tobycm/divine-light/cad/divine-light-low-detail.step

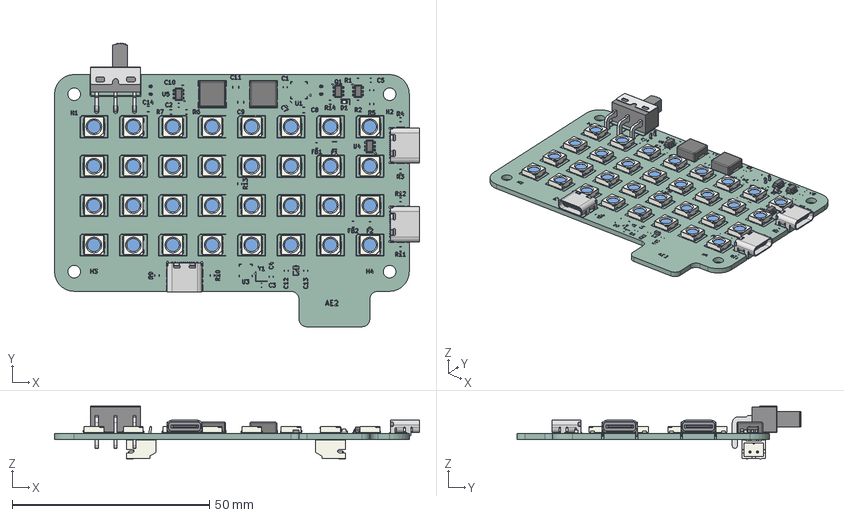
[picture p5: CAD file, 2026-11-07]
cad/divine-light-low-detail.step
92.6 x 72.0 x 13.4 mm
L_APV_APH0630 x 2
LED_SK6812_PLCC4_50x50mm_P32mm x 32
LED_0603_1608Metric
SOT-23-6 x 4
SW-TH_3P-P4.80_HX-SS12D10G6-WJ
USB-C-SMD_TYPE-C-6PIN-2MD-073 x 3
L_0603_1608Metric
JST_S2B_PH_K x 2
divine-light_silkscreen x 2
divine-light_PCB
