tobycm/divine-light/cad/divine-light.step

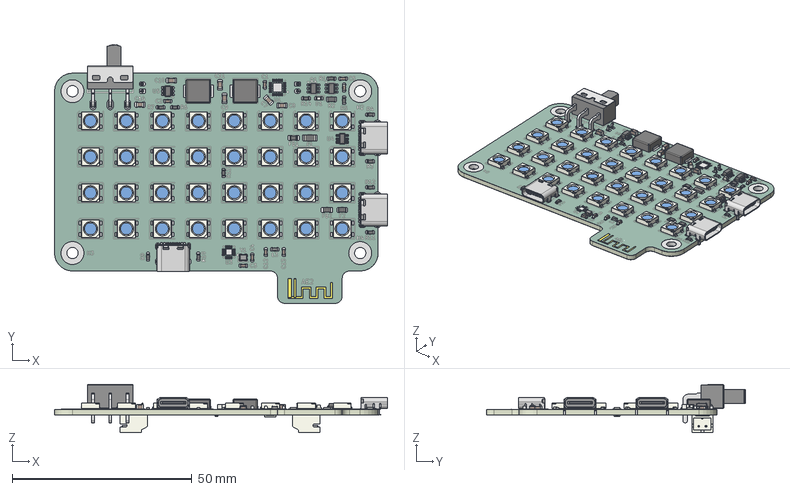
[picture p6: CAD file, 2026-11-06]
cad/divine-light.step
92.6 x 72.0 x 13.4 mm
C_0603_1608Metric x 8
L_APV_APH0630 x 2
R_0603_1608Metric x 13
C_0805_2012Metric x 6
LED_SK6812_PLCC4_50x50mm_P32mm x 32
Fuse_0805_2012Metric
R_0805_2012Metric x 3
LED_0603_1608Metric
Fuse_1206_3216Metric
Crystal_SMD_2016-4Pin_2.0x1.6mm
SOT-23-6 x 4
SW-TH_3P-P4.80_HX-SS12D10G6-WJ
USB-C-SMD_TYPE-C-6PIN-2MD-073 x 3
L_0603_1608Metric
R_1206_3216Metric
JST_S2B_PH_K x 2
divine-light_copper
divine-light_pad
divine-light_via
divine-light_silkscreen x 2
divine-light_soldermask x 2
divine-light_PCB
