tobycm/divine-light/pcb/divine-light.kicad_pcb

## KiCad design pcb/divine-light.kicad_pcb (2026-11-12)

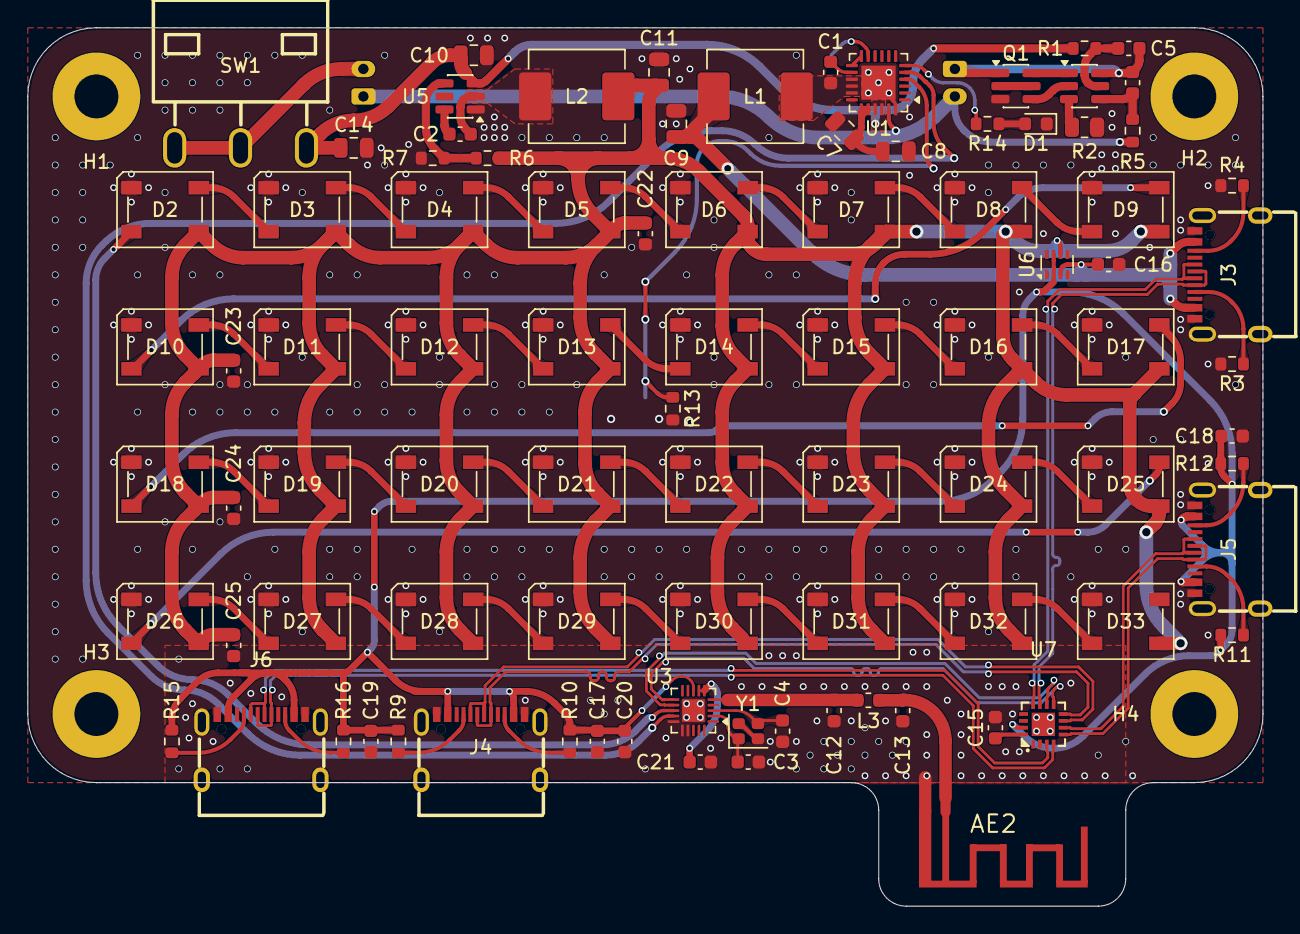
[picture p11: board divine-light.kicad_pcb from above]

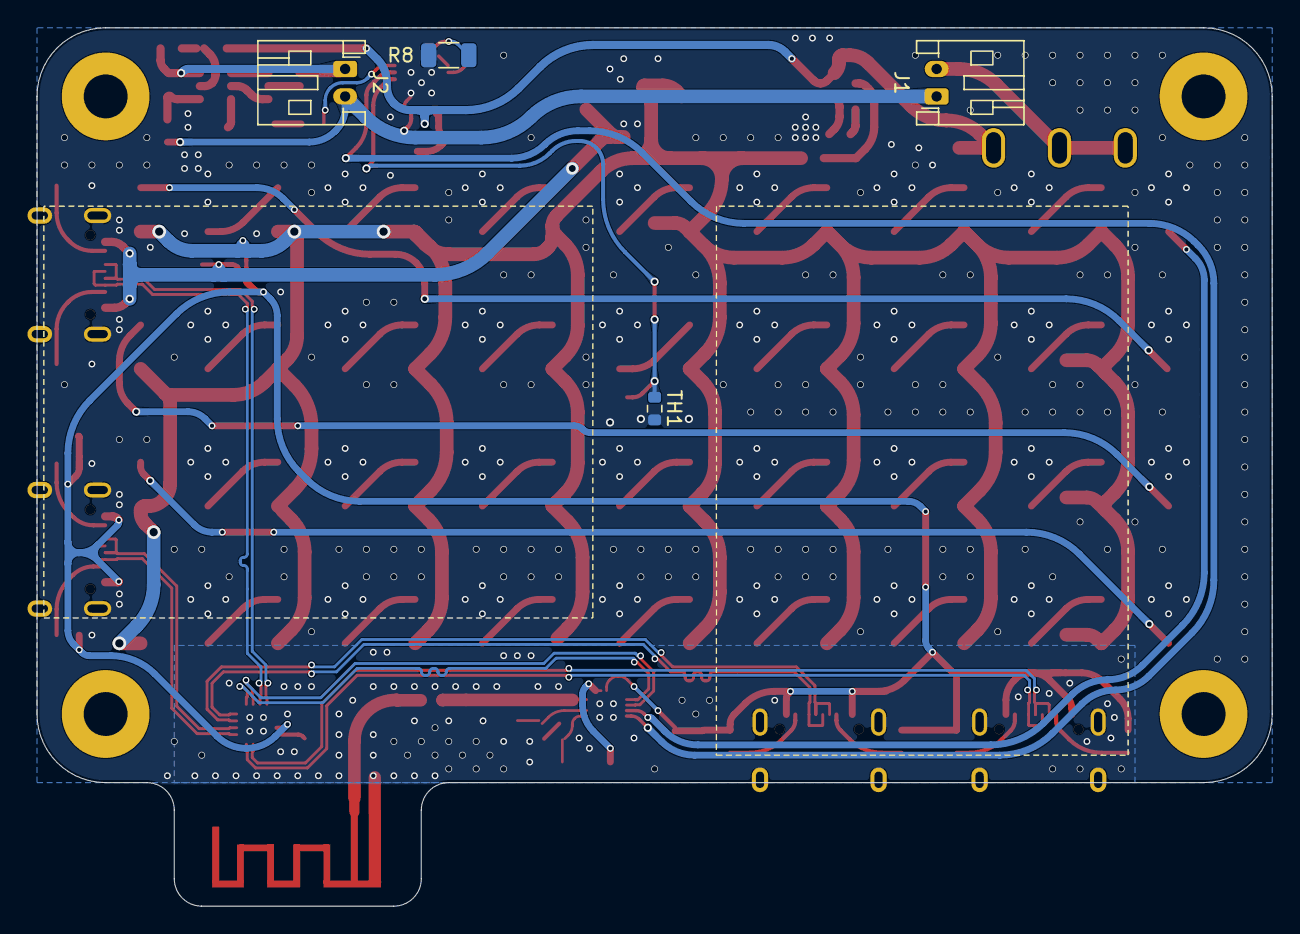
[picture p12: board divine-light.kicad_pcb from below]

Board: 2 copper layers, 90.0 x 64.0 mm, 98 parts (4 on the bottom side), 82 nets.

Parts:
AE2: Antenna_Shield; ANT-F-1-2.4G-1.6MM-FR4-WCH
C1, C2, C5, C6: 100n; C_0603_1608Metric
C3, C4: 8p; C_0603_1608Metric
C7, C8, C9, C10, C11, C14: 22u; C_0805_2012Metric
C12, C13: C; C_0603_1608Metric
C15, C16, C17, C18, C19, C20, C21, C22, C23, C24, C25: 4.7u; C_0603_1608Metric
D1: LED; LED_0603_1608Metric
D2, D3, D4, D5, D6, D7, D8, D9, D10, D11, D12, D13, D14, D15, D16, D17, D18, D19, D20, D21, D22, D23, D24, D25, D26, D27, D28, D29, D30, D31, D32, D33: SK6812; LED_SK6812_PLCC4_5.0x5.0mm_P3.2mm
H1, H2, H3, H4: MountingHole; MountingHole_3.2mm_M3_Pad
J1, J2: Battery_JST; JST_PH_S2B-PH-K_1x02_P2.00mm_Horizontal
J3, J4, J5, J6: USB_C_Receptacle_USB2.0_14P; USB-C-SMD_TYPE-C-16PIN-2MD-073
L1, L2: 2.2u; L_APV_APH0630
L3: L; L_0603_1608Metric
Q1: FS8205A; SOT-23-6
R1, R5, R14: 330; R_0603_1608Metric
R2: 2k; R_0805_2012Metric
R3, R4: 5.1k; R_0603_1608Metric
R6: 10k; R_0603_1608Metric
R7, R9, R10, R11, R12, R15, R16: 56k; R_0603_1608Metric
R8: 180k; R_1206_3216Metric
R13: 82k; R_0603_1608Metric
SW1: SS12D10G6-WJ; SW-TH_3P-P4.80_HX-SS12D10G6-WJ
TH1: 100k @ 3950K; R_0603_1608Metric
U1: IP2326; VQFN-24-1EP_4x4mm_P0.5mm_EP2.5x2.5mm
U2: HY2120CB; SOT-23-6
U3: CH572D; QFN-20-1EP_3x3mm_P0.4mm_EP1.65x1.65mm
U5: TPS54308; SOT-23-6
U6: LM66200DRLR; SOT-583-8
U7: CH334P; QFN-16_L3.0-W3.0-P0.50-BL-EP1.7
Y1: 32Mhz; Crystal_SMD_2016-4Pin_2.0x1.6mm

Connections:
+3V3: C21.1, U3.6 (VDD33), U3.7 (VIO33)
+3V3_USB: C15.1, U7.16 (VDD33)
+5V: C11.1, C22.1, C23.1, C24.1, C25.1, D2.3 (VDD), D3.3 (VDD), D4.3 (VDD), D5.3 (VDD), D6.3 (VDD), D7.3 (VDD), D8.3 (VDD), D9.3 (VDD), D10.3 (VDD), D11.3 (VDD), D12.3 (VDD), D13.3 (VDD), D14.3 (VDD), D15.3 (VDD), D16.3 (VDD), D17.3 (VDD), D18.3 (VDD), D19.3 (VDD), D20.3 (VDD), D21.3 (VDD), D22.3 (VDD), D23.3 (VDD), D24.3 (VDD), D25.3 (VDD), D26.3 (VDD), D27.3 (VDD), D28.3 (VDD), D29.3 (VDD), D30.3 (VDD), D31.3 (VDD), D32.3 (VDD), D33.3 (VDD), L2.2, R6.2, U6.6 (VIN2)
+5V_USB: C17.1, C18.1, C19.1, C20.1, J4.A4 (VBUS), J4.B4 (VBUS), J5.A4 (VBUS), J5.B4 (VBUS), J6.A4 (VBUS), J6.B4 (VBUS), R9.2, R10.2, R11.2, R12.2, R15.2, R16.2, U3.8 (V5), U6.2 (VOUT), U6.7 (VOUT), U7.15 (V5)
+BATT: C10.1, C14.1, R1.1, SW1.1, U1.21 (VOUT), U1.22 (VOUT), U5.3 (VIN)
-BATT: C5.2, C6.2, J2.1, Q1.1 (S1), U2.6 (VSS)
/ANT: C12.1, L3.1, U3.5 (ANT)
/Battery/STAT: U1.5 (BAT_STAT), U3.14 (PA5/SCK/SCL3)
/Battery/VC: J1.1, J2.2, R5.1, U1.23 (VBATM)
/D1D+: J4.A6 (D+), J4.B6 (D+), U7.8 (DP2)
/D1D-: J4.A7 (D-), J4.B7 (D-), U7.7 (DM2)
/D2D+: J5.A6 (D+), J5.B6 (D+), U7.6 (DP3)
/D2D-: J5.A7 (D-), J5.B7 (D-), U7.5 (DM3)
/D3D+: J6.A6 (D+), J6.B6 (D+), U7.4 (DP4)
/D3D-: J6.A7 (D-), J6.B7 (D-), U7.3 (DM4)
/MD+: U3.12 (PA1/UDP/R3/T2/SDA1), U7.10 (DP1)
/MD-: U3.11 (PA0/UDM/R2/T3/SCL1), U7.9 (DM1)
/Neopixel/DIN: D2.2 (DIN), U3.13 (PA4/SCS/PWM4/TMR2)
/UD+: J3.A6 (D+), J3.B6 (D+), U7.12 (DPU)
/UD-: J3.A7 (D-), J3.B7 (D-), U7.11 (DMU)
GND: AE2.2 (Shield), C3.2, C4.2, C7.2, C8.2, C9.2, C10.2, C11.2, C12.2, C13.2, C14.2, C15.2, C16.2, C17.2, C18.2, C19.2, C20.2, C21.2, C22.2, C23.2, C24.2, C25.2, D1.1 (K), D2.1 (VSS), D3.1 (VSS), D4.1 (VSS), D5.1 (VSS), D6.1 (VSS), D7.1 (VSS), D8.1 (VSS), D9.1 (VSS), D10.1 (VSS), D11.1 (VSS), D12.1 (VSS), D13.1 (VSS), D14.1 (VSS), D15.1 (VSS), D16.1 (VSS), D17.1 (VSS), D18.1 (VSS), D19.1 (VSS), D20.1 (VSS), D21.1 (VSS), D22.1 (VSS), D23.1 (VSS), D24.1 (VSS), D25.1 (VSS), D26.1 (VSS), D27.1 (VSS), D28.1 (VSS), D29.1 (VSS), D30.1 (VSS), D31.1 (VSS), D32.1 (VSS), D33.1 (VSS), J3.A1 (GND), J3.B1 (GND), J3.SH (SHIELD), J4.A1 (GND), J4.B1 (GND), J4.SH (SHIELD), J5.A1 (GND), J5.B1 (GND), J5.SH (SHIELD), J6.A1 (GND), J6.B1 (GND), J6.SH (SHIELD), Q1.3 (S2), R2.2, R3.2, R4.2, R7.1, R8.1, R13.2, TH1.2, U1.18 (PGND), U1.24 (VBAT_GND), U1.25 (EP), U3.15 (PA6/MISO/R4/SDA3), U3.16 (PA7/MOSI/T4/PWM1/TMR/RST_/CP1), U3.17 (PA10/R6/T7), U3.21 (GND), U5.1 (GND), U6.1 (GND), U6.4 (~ON), U6.5 (GND), U7.2 (XI), U7.17 (GND), Y1.2 (G), Y1.4 (G)
unnamed: AE2.1 (A), C13.1, L3.2
unnamed: C1.1, L1.2, U1.15 (LX), U1.16 (LX), U1.17 (LX)
unnamed: C7.1, C8.1, U1.19 (VSYS), U1.20 (VSYS)
unnamed: D1.2 (A), R14.1
unnamed: D2.4 (DOUT), D3.2 (DIN)
unnamed: D3.4 (DOUT), D4.2 (DIN)
unnamed: D4.4 (DOUT), D5.2 (DIN)
unnamed: D5.4 (DOUT), D6.2 (DIN)
unnamed: D6.4 (DOUT), D7.2 (DIN)
unnamed: D7.4 (DOUT), D8.2 (DIN)
unnamed: D8.4 (DOUT), D9.2 (DIN)
unnamed: D9.4 (DOUT), D10.2 (DIN)
unnamed: D10.4 (DOUT), D11.2 (DIN)
unnamed: D11.4 (DOUT), D12.2 (DIN)
unnamed: D12.4 (DOUT), D13.2 (DIN)
unnamed: D13.4 (DOUT), D14.2 (DIN)
unnamed: D14.4 (DOUT), D15.2 (DIN)
unnamed: D15.4 (DOUT), D16.2 (DIN)
unnamed: D16.4 (DOUT), D17.2 (DIN)
unnamed: D17.4 (DOUT), D18.2 (DIN)
unnamed: D18.4 (DOUT), D19.2 (DIN)
unnamed: D19.4 (DOUT), D20.2 (DIN)
unnamed: D20.4 (DOUT), D21.2 (DIN)
unnamed: D21.4 (DOUT), D22.2 (DIN)
unnamed: D22.4 (DOUT), D23.2 (DIN)
unnamed: D23.4 (DOUT), D24.2 (DIN)
unnamed: D24.4 (DOUT), D25.2 (DIN)
unnamed: D25.4 (DOUT), D26.2 (DIN)
unnamed: D26.4 (DOUT), D27.2 (DIN)
unnamed: D27.4 (DOUT), D28.2 (DIN)
unnamed: D28.4 (DOUT), D29.2 (DIN)
unnamed: D29.4 (DOUT), D30.2 (DIN)
unnamed: D30.4 (DOUT), D31.2 (DIN)
unnamed: D31.4 (DOUT), D32.2 (DIN)
unnamed: D32.4 (DOUT), D33.2 (DIN)
unnamed: J1.2, SW1.2, SW1.3
unnamed: J3.A5 (CC1), R3.1
unnamed: J3.B5 (CC2), R4.1
unnamed: J4.A5 (CC1), R9.1
unnamed: J4.B5 (CC2), R10.1
unnamed: J5.A5 (CC1), R11.1
unnamed: J5.B5 (CC2), R12.1
unnamed: J6.A5 (CC1), R15.1
unnamed: J6.B5 (CC2), R16.1
unnamed: Q1.2 (D1), Q1.5 (D2)
unnamed: Q1.6 (G1), U2.1 (OD)
unnamed: Q1.4 (G2), U2.2 (OC)
unnamed: C1.2, U1.14 (BST)
unnamed: U1.12 (EN), U1.13 (VIN)
unnamed: R8.2, U1.11 (ISET)
unnamed: R14.2, U1.6 (LED)
unnamed: R13.1, TH1.1, U1.4 (NTC)
unnamed: R2.1, U2.3 (CS)
unnamed: C6.1, R5.2, U2.4 (VC)
unnamed: C5.1, R1.2, U2.5 (VDD)
unnamed: C4.1, U3.3 (XI), Y1.3
unnamed: C3.1, U3.2 (XO), Y1.1
unnamed: C2.1, U5.6 (BOOT)
unnamed: R6.1, R7.2, U5.4 (FB)
unnamed: C2.2, L2.1, U5.2 (SW)
VBUS: C9.1, C16.1, J3.A4 (VBUS), J3.B4 (VBUS), L1.1, U6.3 (VIN1)
