tobycm/divine-light/(commit log)

2026-08-31 long time no commit :skull:
    [battery.kicad_sch, divine-light.kicad_pcb, divine-light.kicad_sch]
2026-10-22 add neopixel sheet, finished battery and main circuitry
    [battery.kicad_sch, divine-light.kicad_pcb, divine-light.kicad_sch, neopixel.kicad_sch]
2026-10-27 initial pcb routing done
    [battery.kicad_sch, divine-light.kicad_pcb, divine-light.kicad_sch, neopixel.kicad_sch]
2026-11-06 moved antenna and improved ch572d layout
    [divine-light.kicad_pcb, divine-light.kicad_sch]
2026-11-06 add 3 vias lol
    [divine-light.kicad_pcb]
2026-11-06 add pcb step file and fix switch 3d model + ref
    [Banana.STEP, battery.kicad_sch, divine-light.kicad_pcb, divine-light.step]
2026-11-06 add high detail model
    [divine-light-low-detail.step, divine-light.step]
2026-11-07 add example firmware and update readme
    [BOM-divine-light.csv, battery.kicad_sch, bom.csv, divine-light-low-detail.step, divine-light.kicad_pcb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]
2026-11-08 add a whole usb hub to the board lmao
    [BOM-divine-light.csv, battery.kicad_sch, bom.csv, divine-light.kicad_pcb, divine-light.kicad_sch, usb.kicad_sch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]
2026-11-12 add schematic pdf and decoupling caps to usb ports
    [divine-light.kicad_pcb, divine-light.kicad_sch]
2026-11-12 added more decoupling caps, added note to schematic, updated gerbers and schematic
    [BOM-divine-light.csv, divine-light.kicad_pcb, divine-light.kicad_sch, neopixel.kicad_sch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]
